tessel/hardware/beta/images/TM-00-00-ports.png

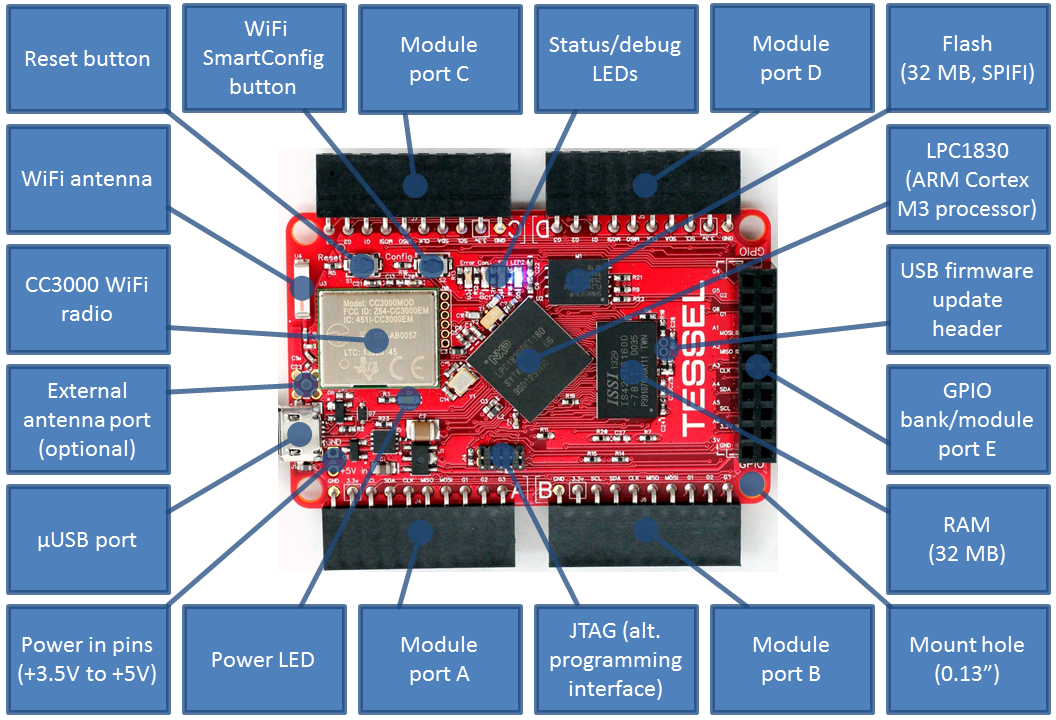
beta/images/TM-00-00-ports.png
