tessel/hardware/beta/images/tm-00-03.jpg

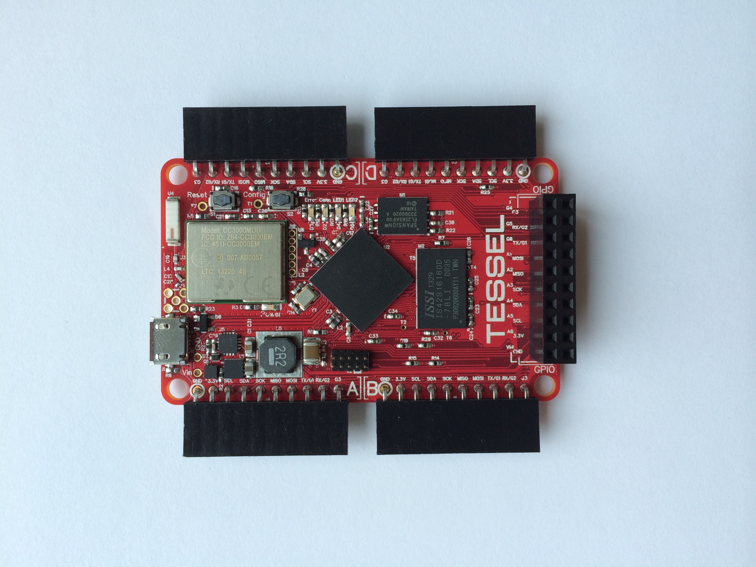
beta/images/tm-00-03.jpg
