tessel/hardware/beta/schematics/README.md

#Tessel Schematics

This is the current schematic of Tessel. There may be future changes.

## Power Distribution
Tessel power

Tessel usb

## WiFi
Tessel wifi

## SDRAM
Tessel sdram

## Flash
Tessel flash

## LPC ports
Tessel ports

Tessel ports2

Tessel gpio
