tessel/hardware/design-files.md

# Open source hardware design files for Tessel and its Modules

Below are PDF and [DipTrace](http://diptrace.com/downloads/download-diptrace/) schematics for Tessel and its modules. Board layout files (and supporting files for silkscreen) are provided in DipTrace format.

All files and designs are licensed under CC-BY-SA.

## Tessel

### PDF

* [Schematic](http://design-files.tessel.io.s3.amazonaws.com/2014.06.06/Tessel/TM-00-04.pdf)
* [Board](http://design-files.tessel.io.s3.amazonaws.com/TM-00-04-phy.pdf)

### DipTrace files

* [DipTrace ZIP](https://s3.amazonaws.com/design-files.tessel.io/2014.06.06/Tessel/TM-00-04_DipTrace.zip)

### 3D models

* [.WRL](http://design-files.tessel.io.s3.amazonaws.com/tm-00-04.wrl)

**NOTE:** many components on the board lack proper 3D models (we used the closest thing we could find), so don't trust them to more than ~0.5mm. Board dimensions and holes are correct, though.

## Modules

### Accelerometer

#### Schematic

* [PDF](http://design-files.tessel.io.s3.amazonaws.com/2014.06.06/Modules/Accelerometer/TM-01-02.pdf)
* [DipTrace](http://design-files.tessel.io.s3.amazonaws.com/2014.06.06/Modules/Accelerometer/TM-01-02.dch)

#### Layout

* [Diptrace](http://design-files.tessel.io.s3.amazonaws.com/2014.06.06/Modules/Accelerometer/TM-01-02.dip), [support file for silkscreen](http://design-files.tessel.io.s3.amazonaws.com/2014.06.06/Modules/Accelerometer/TM-01-02.dipb2)

### Ambient

#### Schematic

* [PDF](http://design-files.tessel.io.s3.amazonaws.com/2014.06.06/Modules/Ambient/TM-08-03.pdf)
* [DipTrace](http://design-files.tessel.io.s3.amazonaws.com/2014.06.06/Modules/Ambient/TM-08-03.dch)

#### Layout

* [Diptrace](http://design-files.tessel.io.s3.amazonaws.com/2014.06.06/Modules/Ambient/TM-08-03.dip), [support file for silkscreen](http://design-files.tessel.io.s3.amazonaws.com/2014.06.06/Modules/Ambient/TM-08-03.dipb2)

### Audio

#### Schematic

* [PDF](http://design-files.tessel.io.s3.amazonaws.com/2014.06.06/Modules/Audio/TM-06-05.pdf)
* [DipTrace](http://design-files.tessel.io.s3.amazonaws.com/2014.06.06/Modules/Audio/TM-06-05.dch)

#### Layout

* [Diptrace](http://design-files.tessel.io.s3.amazonaws.com/2014.06.06/Modules/Audio/TM-06-05.dip), [support file for silkscreen](http://design-files.tessel.io.s3.amazonaws.com/2014.06.06/Modules/Audio/TM-06-05.dipb3)

### BLE

#### Schematic

* [PDF](http://design-files.tessel.io.s3.amazonaws.com/2014.06.06/Modules/BLE/TM-07-04.pdf)
* [DipTrace](http://design-files.tessel.io.s3.amazonaws.com/2014.06.06/Modules/BLE/TM-07-04.dch)

#### Layout

* [Diptrace](http://design-files.tessel.io.s3.amazonaws.com/2014.06.06/Modules/BLE/TM-07-04.dip), [support file for silkscreen](http://design-files.tessel.io.s3.amazonaws.com/2014.06.06/Modules/BLE/TM-07-04.dipb0)

### Camera

#### Schematic

* [PDF](http://design-files.tessel.io.s3.amazonaws.com/2014.06.06/Modules/Camera/TM-12-01.pdf)
* [DipTrace](http://design-files.tessel.io.s3.amazonaws.com/2014.06.06/Modules/Camera/TM-12-01.dch)

#### Layout

* [Diptrace](http://design-files.tessel.io.s3.amazonaws.com/2014.06.06/Modules/Camera/TM-12-01.dip), [support file for silkscreen](http://design-files.tessel.io.s3.amazonaws.com/2014.06.06/Modules/Camera/TM-12-01.dipb1)

### Climate

#### Schematic

* [PDF](http://design-files.tessel.io.s3.amazonaws.com/2014.06.06/Modules/Climate/TM-02-02.pdf)
* [DipTrace](http://design-files.tessel.io.s3.amazonaws.com/2014.06.06/Modules/Climate/TM-02-02.dch)

#### Layout

* [Diptrace](http://design-files.tessel.io.s3.amazonaws.com/2014.06.06/Modules/Climate/TM-02-02.dip), [support file for silkscreen](http://design-files.tessel.io.s3.amazonaws.com/2014.06.06/Modules/Climate/TM-02-02.dipb1)

### GPS

#### Schematic

* [PDF](http://design-files.tessel.io.s3.amazonaws.com/2014.06.06/Modules/GPS/TM-09-02.pdf)
* [DipTrace](http://design-files.tessel.io.s3.amazonaws.com/2014.06.06/Modules/GPS/TM-09-02.dch)

#### Layout

* [Diptrace](http://design-files.tessel.io.s3.amazonaws.com/2014.06.06/Modules/GPS/TM-09-02.dip), [support file for silkscreen](http://design-files.tessel.io.s3.amazonaws.com/2014.06.06/Modules/GPS/TM-09-02.dipb0)

### GPRS

#### Schematic

* [PDF](http://design-files.tessel.io.s3.amazonaws.com/2014.06.06/Modules/GPRS/TM-14-01.pdf)
* [DipTrace](http://design-files.tessel.io.s3.amazonaws.com/2014.06.06/Modules/GPRS/TM-14-01.dch)

#### Layout

* [Diptrace](http://design-files.tessel.io.s3.amazonaws.com/2014.06.06/Modules/GPRS/TM-14-01.dip), [support file for silkscreen](http://design-files.tessel.io.s3.amazonaws.com/2014.06.06/Modules/GPRS/TM-14-01.dipb0)

### IR

#### Schematic

* [PDF](http://design-files.tessel.io.s3.amazonaws.com/2014.06.06/Modules/IR/TM-11-03.pdf)
* [DipTrace](http://design-files.tessel.io.s3.amazonaws.com/2014.06.06/Modules/IR/TM-11-03.dch)

#### Layout

* [Diptrace](http://design-files.tessel.io.s3.amazonaws.com/2014.06.06/Modules/IR/TM-11-03.dip), [support file for silkscreen](http://design-files.tessel.io.s3.amazonaws.com/2014.06.06/Modules/IR/TM-11-03.dipb2)

### MicroSD

#### Schematic

* [PDF](https://s3.amazonaws.com/design-files.tessel.io/2014.06.06/Modules/MicroSD/TM-05-04.pdf)
* [DipTrace](https://s3.amazonaws.com/design-files.tessel.io/2014.06.06/Modules/MicroSD/TM-05-04.dch)

#### Layout

* [Diptrace](https://s3.amazonaws.com/design-files.tessel.io/2014.06.06/Modules/MicroSD/TM-05-05.dip), [support file for silkscreen](https://s3.amazonaws.com/design-files.tessel.io/2014.06.06/Modules/MicroSD/TM-05-05.dipb2)

### nRF24

#### Schematic

* [PDF](https://s3.amazonaws.com/design-files.tessel.io/2014.06.06/Modules/nRF/TM-13-01.pdf)
* [DipTrace](https://s3.amazonaws.com/design-files.tessel.io/2014.06.06/Modules/nRF/TM-13-01.dch)

#### Layout

* [Diptrace](https://s3.amazonaws.com/design-files.tessel.io/2014.06.06/Modules/nRF/TM-13-01.dip), [support file for silkscreen](https://s3.amazonaws.com/design-files.tessel.io/2014.06.06/Modules/nRF/TM-13-01.dipb0)

### Relay

#### Schematic

* [PDF](http://design-files.tessel.io.s3.amazonaws.com/2014.06.06/Modules/Relay/TM-04-04.pdf)
* [DipTrace](http://design-files.tessel.io.s3.amazonaws.com/2014.06.06/Modules/Relay/TM-04-04.dch)

#### Layout

* [Diptrace](http://design-files.tessel.io.s3.amazonaws.com/2014.06.06/Modules/Relay/TM-04-04.dip), [support file for silkscreen](http://design-files.tessel.io.s3.amazonaws.com/2014.06.06/Modules/Relay/TM-04-04.dipb2)

### RFID

#### Schematic

* [PDF](http://design-files.tessel.io.s3.amazonaws.com/2014.06.06/Modules/RFID/TM-10-03.pdf)
* [DipTrace](http://design-files.tessel.io.s3.amazonaws.com/2014.06.06/Modules/RFID/TM-10-03.dch)

#### Layout

* [Diptrace](http://design-files.tessel.io.s3.amazonaws.com/2014.06.06/Modules/RFID/TM-10-03.dip), [support file #1 for silkscreen](http://design-files.tessel.io.s3.amazonaws.com/2014.06.06/Modules/RFID/TM-10-03.dipb0), [support file #2 for silkscreen](http://design-files.tessel.io.s3.amazonaws.com/2014.06.06/Modules/RFID/TM-10-03.dipb1)

### Servo

#### Schematic

* [PDF](http://design-files.tessel.io.s3.amazonaws.com/2014.06.06/Modules/Servo/TM-03-03.pdf)
* [DipTrace](http://design-files.tessel.io.s3.amazonaws.com/2014.06.06/Modules/Servo/TM-03-03.dch)

#### Layout

* [Diptrace](http://design-files.tessel.io.s3.amazonaws.com/2014.06.06/Modules/Servo/TM-03-03.dip), [support file for silkscreen](http://design-files.tessel.io.s3.amazonaws.com/2014.06.06/Modules/Servo/TM-03-03.dipb0)
