tessel/hardware/beta/images/gps_bare.png

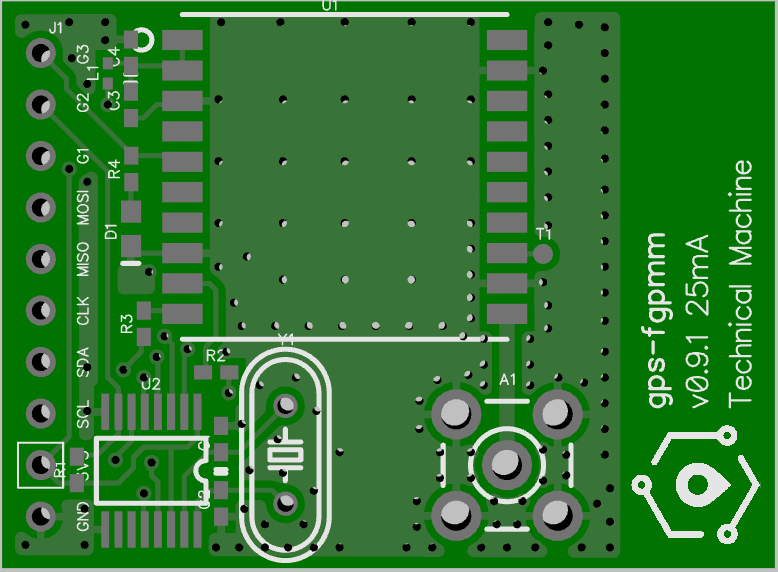
beta/images/gps_bare.png
