tessel/hardware/beta/images/tessel-flash.png

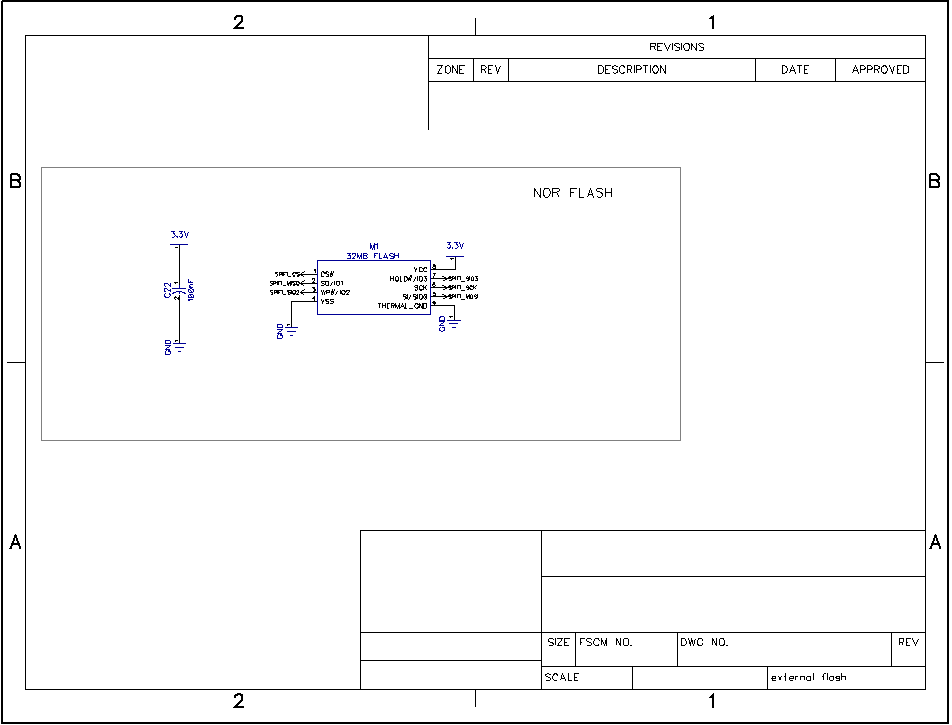
beta/images/tessel-flash.png
