tessel/hardware/beta/images/tessel-gpio.png

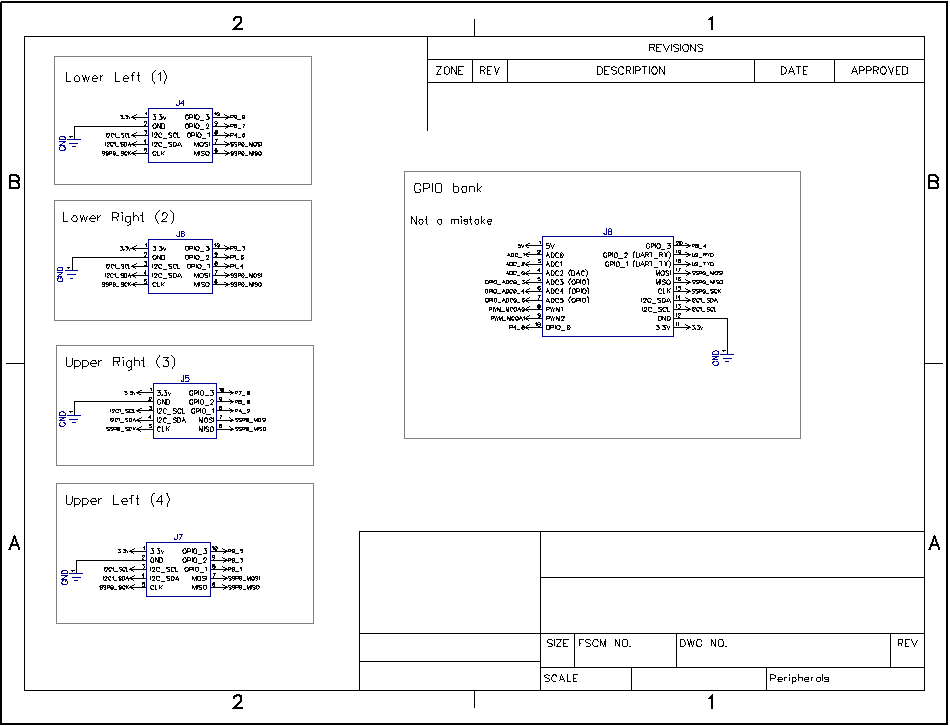
beta/images/tessel-gpio.png
