tessel/hardware/beta/images/tessel-lpc-power.png

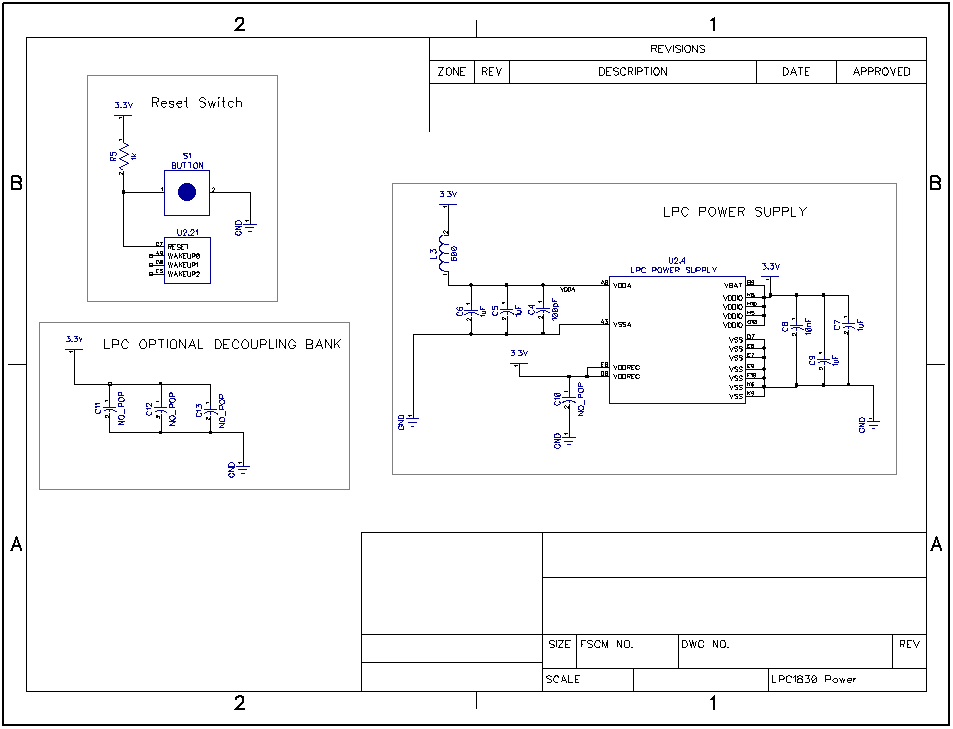
beta/images/tessel-lpc-power.png
