tessel/hardware/beta/images/tessel-ports2.png

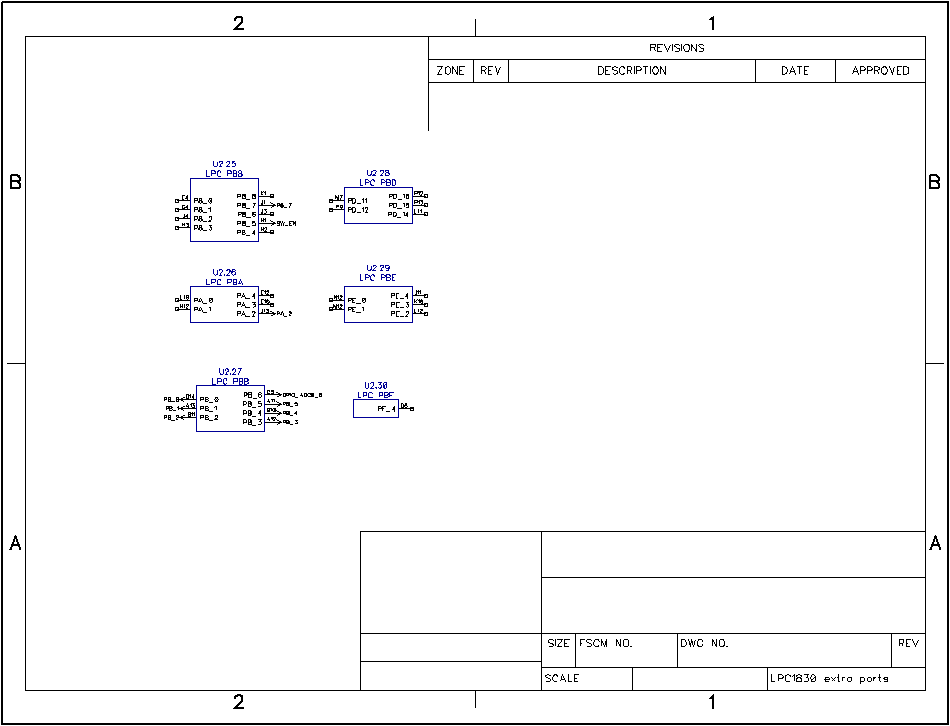
beta/images/tessel-ports2.png
