tessel/hardware/beta/images/tessel-ports.png

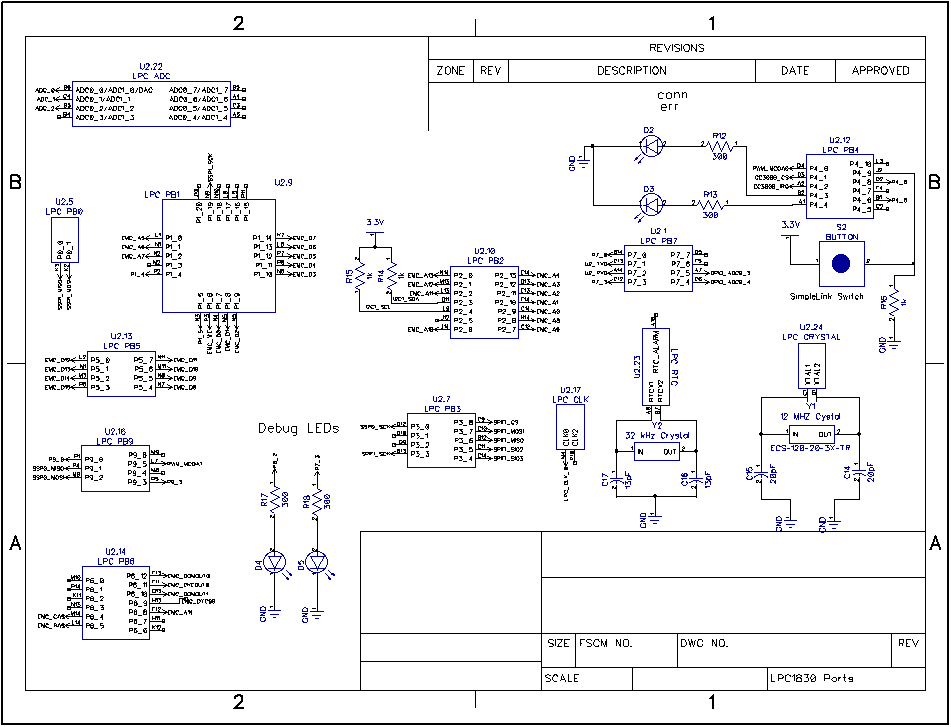
beta/images/tessel-ports.png
