tessel/hardware/beta/images/tessel-power.png

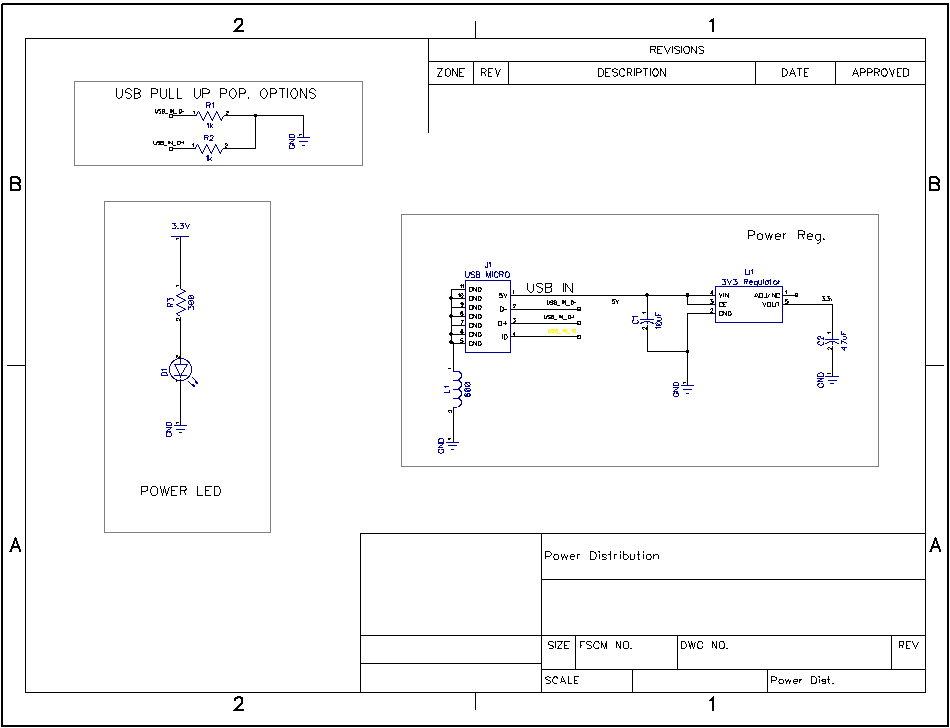
beta/images/tessel-power.png
