tessel/hardware/beta/images/tessel-sdram.png

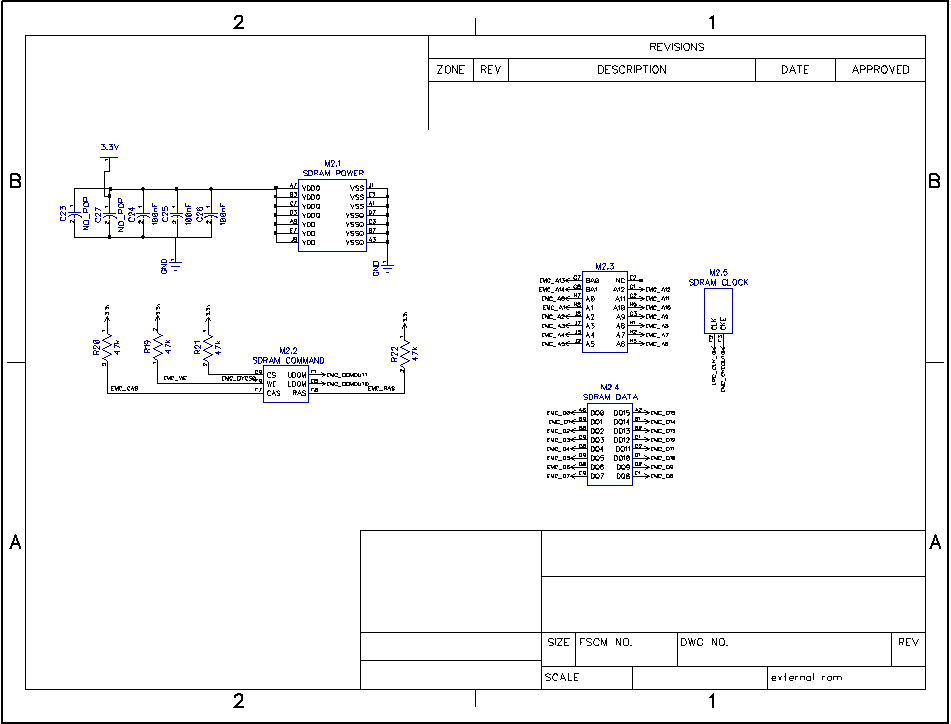
beta/images/tessel-sdram.png
