tessel/hardware/beta/images/tessel-usb.png

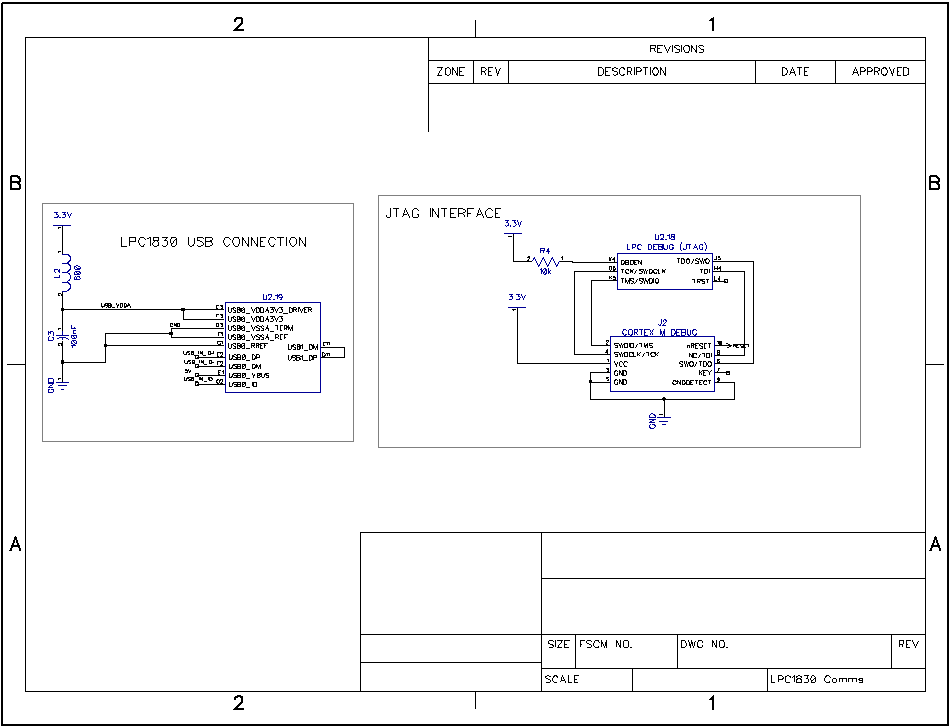
beta/images/tessel-usb.png
