tessel/hardware/beta/images/tessel-wifi.png

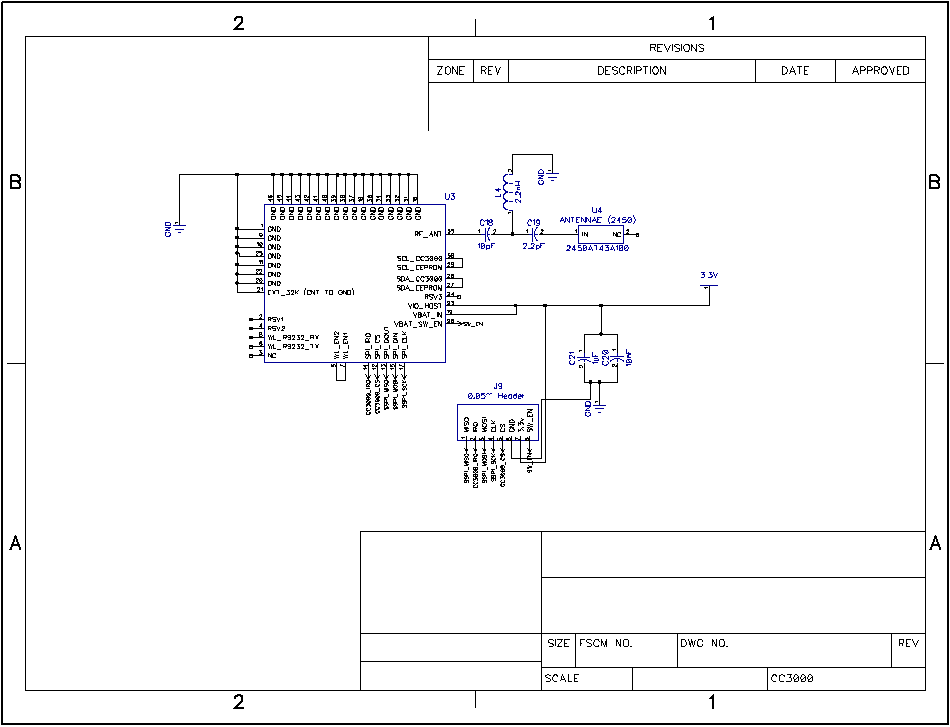
beta/images/tessel-wifi.png
