tessel/hardware/beta/images/tessel_ports.png

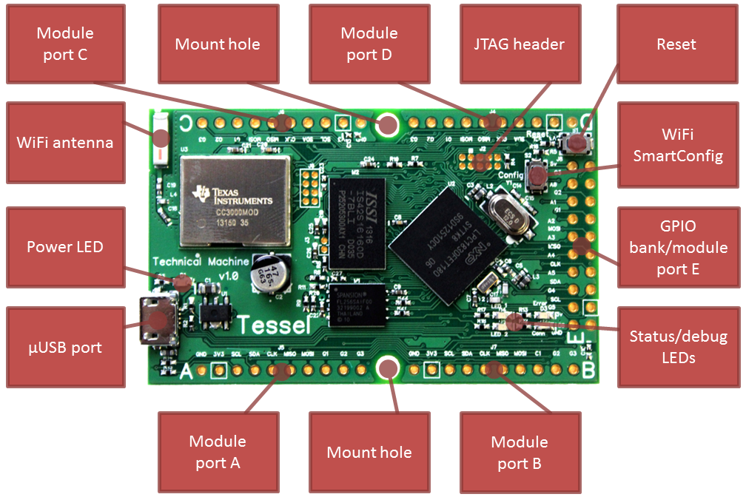
beta/images/tessel_ports.png
