tessel/hardware/beta/images/TM-00-00-fullyloaded-bottom.jpg

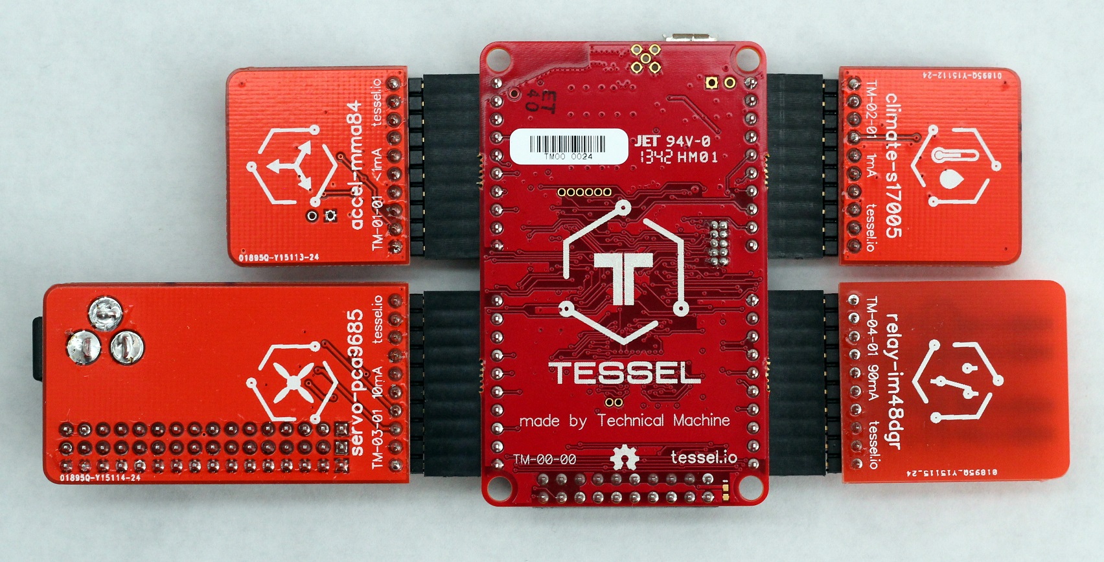
beta/images/TM-00-00-fullyloaded-bottom.jpg
