tessel/hardware/beta/images/TM-00-00-fullyloaded-top.jpg

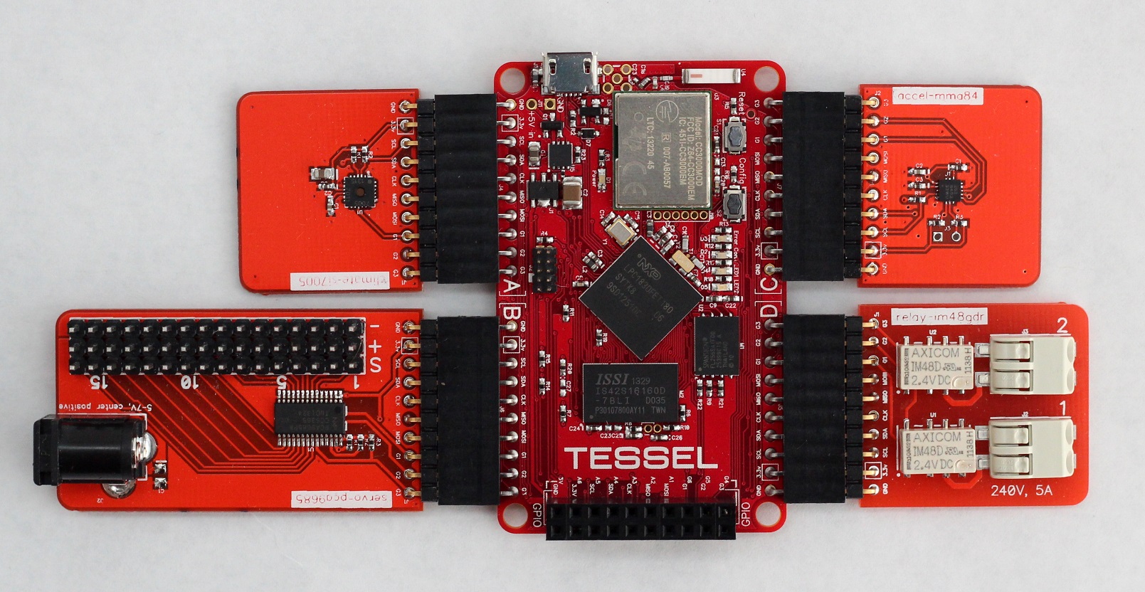
beta/images/TM-00-00-fullyloaded-top.jpg
