tessel/hardware/beta/images/tm-00-04.jpg

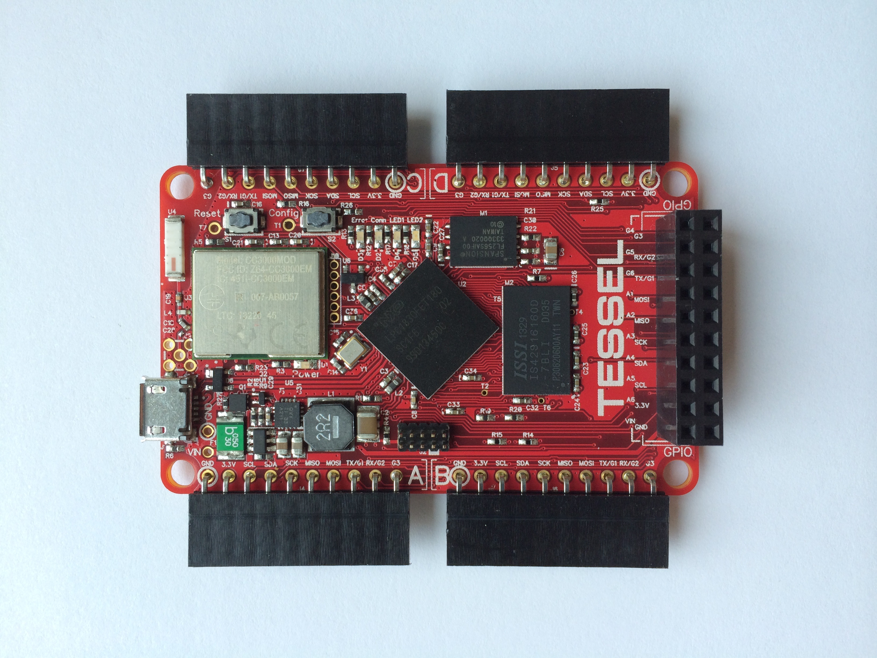
beta/images/tm-00-04.jpg
