tessel/hardware/(list of files, drawings)

Other design files:
beta/schematics/tessel-release-schematic.dch
