tessel/hardware/(commit log)

2013-09-20 added schematic
    [tessel-release-schematic.dch]
2013-11-24 i2c is no longer shared board-wide
2013-11-24 swapped pins for GPIO bank, but ADC alt. functions and #s are wrong
2014-02-05 updated schematic for TM-00-02 boards!
2014-04-07 added -03 and -04 board images
2014-04-16 beta stuff isolated
    [tessel-release-schematic.dch]
2014-04-16 added powering-tessel.md
2014-04-16 landing page and licensing placeholder
2014-04-16 added schematic pdf for tm-00-04
2014-05-02 starting to switch assets over to s3
2014-05-02 switched to s3 assets
2014-05-12 Update modules-overview.md
    Update GPS description, link to module user manual instead of Eval Kit, and latest complete power mode values
2014-05-15 link to schematic
2014-05-23 adding instructions for the external wifi antenna mod/hack
2014-05-23 draft 1 of wifi antenna instructions
2014-05-23 link to antenna hack on readme
2014-06-23 fixed datasheet and manual for camera docs
2014-11-17 hard-coded power docs link
